ra3vld/esp32-cases/LICENSES/README.md

# License scope

Copyright (c) 2026 Dmitry E (RA3VLD).

- Python, JavaScript and HTML/CSS source code: MIT, see the root `LICENSE`.
- Enclosure CAD designs, parameters, generated STEP/STL models, drawings, documentation, renders and the contributed project photograph: Creative Commons Attribution 4.0 International (CC BY 4.0), see `CC-BY-4.0.txt`.
- The simplified CrowPanel reference model is constructed from primitives by this project and is included in the CAD license above. It is not the manufacturer's detailed STEP model.
- Font software and its embedded subsets retain the notices in `DejaVu.txt`. Third-party software installed as build dependencies retains its own license.

Attribution for the project's non-code content: "ESP32 Cases by Dmitry E (RA3VLD), https://github.com/ra3vld/esp32-cases, CC BY 4.0". Indicate changes when sharing modified content. The content license allows commercial use, modification and redistribution, including manufacture of the enclosure designs.

External reference documents linked by the project are not relicensed or included in the distribution. See the root `THIRD_PARTY_NOTICES.md`.
