ra3vld/esp32-cases/esp32-3248s035c/capsule-v01/README.md

# Капсула 0.1 — ESP32-3248S035C

Настольный корпус **142 × 91,8 × 91 мм без присосок**. Экран расположен горизонтально с наклоном **15° назад от вертикали**. Внутри предусмотрены дисплейная плата и интерфейс тюнера **40 × 25 × 25 мм**. Кабель Ø5 мм фиксируется разгрузочным зажимом.

Лицевая рамка, задняя крышка и подошва соединяются с корпусом замкнутыми бортиками **1,6 × 3 мм** с зазором **0,3 мм**. Лицевая панель без наружных винтов и дополнительного стекла. Кнопки RESET/BOOT доступны через два отверстия Ø2 мм в задней крышке.

## Файлы

- [STL для печати](output/print_stl/) — шесть деталей корпуса и два пробника, миллиметры, масштаб 100%.
- [Чертежи, 10 листов](output/capsule-v01-drawings.pdf).
- STEP сборки: `output/assembly.step` и [отдельных деталей](output/step/).
- Автономный 3D-просмотрщик: `output/capsule-3d.html`, [внешний вид](output/cad-preview.png), [разнесённая сборка](output/cad-construction.png).
- [Передний стык](output/cad-front-joint.png), [бортики и стойки](output/cad-skirts-and-roots.png), [нижний стык и спинка](output/cad-surface-details.png).

`output/stl/` содержит сетки в координатах сборки. В `output/reference_step/` находятся габаритные модели электроники, присосок и крепежа для компоновки.

Готовый комплект STEP/STL, сборка и HTML-просмотрщик находятся в [архиве корпуса из релиза](https://github.com/ra3vld/esp32-cases/releases/latest/download/ldg-capsule-v01.zip).

## Совместимость

Плата: **101,5 × 54,9 мм**, шаг креплений **94,5 × 47,9 мм**, активная область экрана **73,44 × 48,96 мм**. Размеры основаны на [документации Jingcai](https://www.guition.com/icms/upload/fb081940d6fc11f09850077a33e1404f/FTPData/UEditor/file/2026121/1768961091987/ESP32-3248S035%20Specifications-EN.pdf). Параметры посадок находятся в `parameters.json`.

Карман стекла: **85,5 × 54,9 мм** с зазором **0,3 мм** по сторонам; стекло углублено на **1,7 мм** от лицевой поверхности. Опоры PCB имеют высоту **3,8 мм**. Центр окна смещён вправо на **2 мм** относительно центра платы при взгляде спереди. Для USB предусмотрен корпус штекера до **23 × 12 × 6,8 мм**.

Перед полной печатью примерить плату, стекло, USB-штекер и световые отверстия на пробнике `08_board_coupon`; оси кнопок сверить с задней крышкой. Для другой ревизии платы скорректировать посадки в параметрах. Термовставки и присоски подобрать на пробнике `07_fit_coupon`.

## Печать

| Файл | Ориентация в `print_stl` | Поддержки |
|---|---|---|
| `01_front_frame` | Лицевой плоскостью на стол, опорами вверх | Не нужны. Непрозрачный тёмный PETG; оптические отверстия оставить чистыми. |
| `02_body` | Нижним торцом на стол | Под нижним носом, верхом переднего проёма и нависающими внутренними опорами. Удаление доступно через три открытых проёма. |
| `03_rear_cover` | Задней центральной площадкой вниз, бортиком вверх | Локальные поддержки от стола под краями оболочки и внутренними площадками, плюс brim. Отверстия кнопок Ø2 не заполнять поддержками; выступающих трубок нет. |
| `04_sole` | Наружной нижней плоскостью вниз | Не нужны; проверить короткие мосты над цековками. |
| `05_interface_cassette` | Широкой нижней плоскостью вниз | Не нужны; каналы стяжек открыты снизу. |
| `06_cable_clamp` | Верхней плоскостью вниз, канавкой вверх | Не нужны. Нижняя половина зажима встроена в подошву. |
| `07_fit_coupon` | Плоской стороной вниз | Печатать первым, затем разделить элементы по перемычкам 0,6 мм. |
| `08_board_coupon` | Лицевой плоскостью вниз | Печатать первым для примерки платы, стекла, USB и оптики. |

Начальный профиль: слой **0,20 мм**, **4 периметра**, **5 верхних/нижних слоёв**, заполнение **25%**. Вокруг стоек и их корней - локально **6 периметров и 50%**. Температуры и обдув - по своему PETG. Компенсацию слоновьей ноги настроить по пробнику. Положение поддержек проверить в слайсере.

## Бортики и крепёж

Бортики **1,6 × 3 мм**, заходная фаска **0,2 × 45°**. Они замкнуты, без разрывов у винтов, кнопок, кабеля и присосок. Снаружи бортика до направляющей стенки — **0,3 мм**; от сборочного датума до упора — **3,3 мм**, за торцом бортика остаётся **не менее 0,3 мм**. У бокового USB-окна осевой упор открыт, боковая направляющая сохранена. Между наружными торцами — **0,3 мм**. Винты стягивают отдельные опорные площадки. Приёмная ступень и свободная внутренняя полость показаны на листе 8 PDF.

Зажим кабеля: основание 30 × 10 мм на подошве, отдельная крышка толщиной 6,5 мм, два M3 × 8 и два направляющих штифта Ø2,4 × 2. Ось кабеля X = -32, Z = 13; центр зажима Y = 60,5. Входные фаски канавки Ø5 расширены до Ø5,8. До затяжки зазор половинок 0,3 мм; затягивать до удержания оболочки. Основание не обрезается полостью присоски.

Присоски: передняя пара X = ±44, Y = 20; задняя X = ±54, Y = 62. Модуль 40 × 25 × 25 расположен в центре X = 6, Y = 46, низ Z = 8. Эти положения дают запас между головками присосок, непрерывным бортиком, зажимом и стойками.

| Комплектующая | Количество | Назначение |
|---|---:|---|
| M3 × 6 ISO 7380-1 | **10** | Плата 4, подошва 4, кассета 2 |
| M3 × 8 ISO 7380-1 | **2** | Прижим кабеля |
| M3 × 10 ISO 7380-1 | **4** | Рамка изнутри |
| M3 × 12 ISO 7380-1 | **4** | Задняя крышка, головки в глубоких колодцах |
| Термовставка M3, наружный Ø4,6 × 4,0 | **20** | Рамка 8; корпус 8; подошва 4 |
| Присоска Ø20, под вставное крепление Ø6 | **4** | Эффективная толщина посадки 2 мм, сверху полость Ø12,8 |
| Стяжка 2,5 × 150 или длиннее | **2** | Интерфейс на кассете |
| Кабель наружным Ø5 | **1** | Соединение с тюнером |

Головки винтов - низкие, Ø5,7 × 1,65 мм. Другие головки или увеличенную длину сначала проверить по STEP. Начальный пилот термовставок Ø4,2 × 4,4 мм; подобрать по пробнику для фактической вставки. Не масштабировать весь корпус ради отверстий.

## Сборка и обслуживание

1. Напечатать **07 и 08**. В 07 верхний ряд слева: 5,8 / 6,0 / 6,2 мм; справа: пилоты 4,0 / 4,2 / 4,4 мм. Отделить нижние элементы, правый перевернуть и проверить стык. Проверить реальную присоску через перемычку 2 мм.
2. На 08 проверить четыре крепления, стекло, отсутствие изгиба PCB, ввод своего USB-штекера и оси оптики. Положение RESET/BOOT проверить отдельной примеркой крышки. При расхождении исправить параметры и пересобрать комплект до полной печати.
3. Напечатать детали, удалить поддержки и заусенцы. **При снятой электронике** вплавить вставки: в рамку восемь со стороны PCB; в корпус четыре сзади и четыре снизу; в подошву четыре сверху. Дать пластику остыть.
4. Прикрутить плату к опорам рамки четырьмя M3 × 6. Усилие передаётся через PCB; стекло и шлейф свободны. По принятому осевому размеру между стеклом и карманом остаётся 0,3 мм; стекло углублено относительно лицевой поверхности на 1,7 мм. LED и датчик остаются на плате; каналы раздельные.
5. При снятой подошве вставить рамку с платой спереди; через снятую заднюю крышку установить четыре M3 × 10 со стороны внутренней полости. Оси крепления рамки: U = ±54; V = ±21. Головки находятся за опорными площадками корпуса; винты входят в глухие вставки рамки. Доступ длинным шестигранником 2 мм с шаровым концом через внутренние каналы Ø5,1; отклонение к центру не более 10°. Колодцы головок Ø6,2 остаются внутри. На лицевой поверхности нет отверстий крепежа. Все крышки направляются своими бортиками относительно основного корпуса.
6. Уложить интерфейс в кассету, закрепить двумя стяжками без давления на компоненты. Прикрутить кассету к подошве двумя M3 × 6. Запас кармана по длине/ширине - 0,5 мм на сторону.
7. Провести кабель сзади, уложить в канавку подошвы, установить прижим на два M3 × 8. Подтянуть до удержания оболочки без повреждения. Оставить монтажную петлю, подключить провода. Не проводить их над антенной.
8. Установить заднюю крышку с отверстиями RESET/BOOT без направляющих трубок, закрепить четырьмя M3 × 12. Установить подошву с кассетой и четырьмя M3 × 6; не защемить провода. Вставить присоски.
9. Проверить USB, обе кнопки распрямлённой скрепкой Ø1 мм длиной от 80 мм, касания по краям, датчик при выключенном/включённом LED. Для доступа освободить зажим кабеля и отсоединить внутреннюю проводку, снять подошву с кассетой, затем снять четыре винта задней крышки и вытянуть её назад. После этого доступен внутренний крепёж передней панели.

## Пересборка CAD

Python 3.12. Выполнять из каталога `esp32-3248s035c/capsule-v01/`:

```sh
python3 -m venv .venv
.venv/bin/python -m pip install -r requirements.lock.txt
.venv/bin/python build.py
.venv/bin/python validate.py
.venv/bin/python preview.py
.venv/bin/python drawings.py
.venv/bin/python package.py
```

Для пересборки использовать исходники вместе с комплектными каталогами `output/step/`, `output/stl/`, `output/print_stl/` и файлом `compatibility-baseline.json`.

Для PDF установить шрифты DejaVu Sans; для PNG используется VTK с внеэкранным рендером. На Debian/Ubuntu шрифты устанавливаются пакетом `fonts-dejavu-core`.

Размеры и посадки задаются в `parameters.json`, форма деталей — в `build.py`. После выполнения команд готовый комплект находится в `ldg-capsule-v01.zip`.
