ra3vld/esp32-cases/crowpanel/mechanical/capsule-v03/README.md

# CrowPanel 2.1 — «Капсула», версия 0.3

Настольный корпус для Elecrow CrowPanel 2.1 с круглым экраном и энкодером. Основание **94 × 88 мм**, наклон **15° назад от вертикали**, нижний просвет **22 мм**, зазор за кольцом **1,6 мм**.

PETG, сопло **0,4 мм**, слой **0,20 мм**, стол от **180 × 180 мм**.

## Конструкция и файлы

Дисплей крепится на съёмном держателе `07_display_carrier`: четыре винта M3×12 соединяют его с корпусом, три M3×8 — со штатными металлическими стойками модуля. Ветви держателя имеют толщину **8 мм**, центральная площадка — **12 мм**. Плата и вращающееся кольцо остаются свободными.

Задняя и нижняя крышки закреплены на стойках **Ø13 мм** с рёбрами. Сзади предусмотрен выход питания **9 × 7 мм**, снизу — место под утяжелитель, магниты и присоски.

- STL для печати: `output/print_stl/`, STEP деталей: `output/step/` и сборки: `output/assembly.step`.
- Автономный 3D-просмотрщик: `output/capsule-3d.html`.
- [Внешний вид](output/cad-preview.png), [разнесённая сборка](output/cad-construction.png), [держатель и усиления](output/reinforcement-preview.png).

Готовые файлы находятся в [архиве корпуса из релиза](https://github.com/ra3vld/esp32-cases/releases/latest/download/crowpanel-capsule-0.3.zip).

## Детали для печати

Использовать детали комплекта 0.3.

Использовать **`output/print_stl/`**, миллиметры, масштаб 100%. Файлы уже ориентированы и поставлены на плоскость стола.

| Файл | Печать |
|---|---|
| `01_body.stl` | Нижним торцом на стол. Проверить локальные поддержки под передним ободом и неподвижными опорными площадками; доступ для удаления открыт через задний проём. |
| `02_rear_cover.stl` | Передней стыковочной плоскостью к столу. Брим около 5 мм, поддержки по результату слайсинга под замыкающейся стенкой и посадками винтов. |
| `03_bottom_cover.stl` | Наружной стороной к столу, рёбрами вверх. Мосты над карманами магнитов Ø12,25 мм проверить в слайсере. |
| `04_cable_clamp.stl` | Плоской нижней стороной на стол. |
| `05_fit_coupon.stl` | Пробник магнитов, присосок и термовставок, печатать первым. |
| `06_mount_test.stl` | Пробник трёх штатных стоек CrowPanel, печатать первым. |
| `07_display_carrier.stl` | **Широкой плоской задней стороной на стол**, центральной площадкой вверх. Без поддержек при нормальных мостах над цековками Ø6,2 мм. Для держателя рекомендуется 6 периметров, 6 верхних/нижних слоёв, заполнение 40–50%. |

Для остальных деталей стартовый профиль: 4 периметра, 5 верхних/нижних слоёв, заполнение 20–25%. Температура и обдув по профилю своего PETG.

`output/stl/` — те же детали в координатах сборки. `output/step/` — точные отдельные CAD-тела. `output/assembly.step` — сборка с упрощённой моделью дисплея, стальной пластиной, магнитами и винтами. Кабель и форма присосок в STEP не включены. Просмотрщик `output/capsule-3d.html` автономный, с режимами «Без задней крышки», «Без держателя», «Разнесённый вид» и «Сетка».

## Крепёж

| Комплектующая | Количество | Назначение |
|---|---:|---|
| M3×8 ISO 7380-1 | 3 | Держатель → три штатные металлические стойки CrowPanel. Заход резьбы около 3,5 мм. |
| M3×12 ISO 7380-1 | **4** | Съёмный держатель → термовставки основного корпуса. Через 8 мм пластика, около 4 мм резьбы во вставке. |
| M3×16 ISO 7380-1 | 4 | Задняя крышка → корпус. |
| M3×8 ISO 7380-1 | 4 | Нижняя крышка → корпус. |
| M3×10 ISO 7380-1 | 2 | Планка фиксации провода → корпус. |
| Термовставки M3, наружный Ø около 4,6 мм, длина 5 мм | **14** | 4 держатель + 4 задняя крышка + 4 подошва + 2 кабельная планка. Отверстия Ø4,3×5,3 мм; подобрать свои вставки по пробнику. |
| Магниты Ø12×3 мм | 4 | Карманы Ø12,25 мм, глубина 3,15 мм, вклеить после примерки. |
| Присоски с вставным хвостиком Ø6 мм | 4 | Отверстия Ø6 мм в стенке толщиной 4 мм, снизу заходная фаска. |
| Стальная пластина 72×46×10 мм | 1 | Утяжелитель около 260 г. |
| Стяжки шириной до 4 мм, толщиной до 1,2 мм, длиной от 250 мм | 2 | Закрепить утяжелитель через прорези и утопленные каналы подошвы. |
| Стяжка шириной 2,5 мм | 1 | Закрепить питание на кабельной планке. |

Принята низкая полукруглая головка ISO 7380-1 Ø5,7×1,65 мм. Высокая цилиндрическая головка может выступать ниже подошвы. Длину винтов не увеличивать без проверки глубины отверстий. Штатные металлические стойки модуля не нагревать.

## Сборка и снятие держателя

1. Напечатать `05_fit_coupon` и `06_mount_test`. Подобрать отверстие под хвостик присоски, магнит и термовставку. Проверить штатные три стойки без изгиба платы.
2. Напечатать корпус, крышки, кабельную планку и держатель. Удалить локальные поддержки и очистить посадочные поверхности.
3. Установить 14 термовставок. Четыре вставки держателя ставятся в неподвижные площадки **сзади вдоль оси дисплея**, четыре вставки задней крышки — горизонтально спереди от её стыка. Четыре нижние и две кабельные вставки ставятся снизу при открытой подошве.
4. Ввести модуль **спереди** через посадочный обод. Удерживая его рукой, завести держатель сзади. Плоские передние поверхности его четырёх ушей должны прилегать к неподвижным площадкам корпуса.
5. Наживить четыре M3×12 в корпус и три M3×8 в штатные металлические стойки. Центральная площадка держателя прилегает к торцам металлических стоек. Проверить длину одного винта вручную, затем равномерно затянуть все семь без перетяжки.
6. Пока задняя крышка снята, подключить необходимые разъёмы. Провести питание вниз и назад через проём 9×7 мм, закрепить кабельной планкой и стяжкой.
7. Вклеить магниты, вставить присоски, уложить стальную пластину и закрепить двумя стяжками. Ленты не должны выступать ниже подошвы. Нижняя крышка крепится четырьмя M3×8, задняя — четырьмя M3×16.
8. Для снятия держателя снять заднюю крышку, придерживать модуль спереди, отвернуть три M3×8 из штатных стоек и четыре M3×12 из корпуса. Держатель выводится назад **вдоль оси дисплея**, то есть с небольшим движением вниз относительно стола. Сам модуль затем извлекается вперёд.

Для нижних вставок и планки кабеля всего шесть мест. На держателе и крышках термовставок нет — там проходные отверстия.

## Посадки

Штатное кольцо Ø79 мм и его боковая поверхность остаются свободными. Координаты заводских стоек в локальной плоскости модуля: (0; 5,95), (−5,15285; −2,975), (+5,15285; −2,975) мм. Для нажатия предусмотрен осевой зазор 1 мм.

Магниты: четыре Ø12×3 мм; сверху карманов остаётся 0,85 мм пластика. Присоски: четыре вставных хвостика Ø6 мм без шпильки. Подобрать посадку хвостика пробником толщиной 4 мм. На металле присоски снять, чтобы магниты прилегали ближе к поверхности.

Пробник: верхний ряд 5,7 / 5,9 / 6,0 / 6,1 / 6,3 мм; нижние карманы магнитов 12,1 / 12,25 / 12,4 мм; крайние цилиндрики под термовставки Ø4,2 и Ø4,3 мм. Всю модель ради коррекции отверстий не масштабировать.

## Пересборка CAD

Python 3.12. Выполнять из каталога `crowpanel/mechanical/capsule-v03/`:

```sh
python3 -m venv .venv
.venv/bin/python -m pip install -r requirements.txt
.venv/bin/python build.py
.venv/bin/python refine_mesh.py
.venv/bin/python preview.py
.venv/bin/python package.py
```

Посадочные размеры задаются в `parameters.json`, форма деталей — в `build.py`. После выполнения команд готовый комплект находится в `crowpanel-capsule-0.3.zip`. Допуск STL — **0,025 мм**.

Упрощённая модель дисплея: `output/crowpanel-module-simplified.step`. Диаметр 79 мм, глубина 33,42 мм с задними разъёмами, три крепления M3.
