ra3vld/esp32-cases/THIRD_PARTY_NOTICES.md

# Third-party notices

## Fonts

The PDF drawings embed subsets of DejaVu Sans and DejaVu Sans Bold. Printable fit coupons also contain glyph outlines generated with DejaVu Sans. The font copyright and permission notices are included in `LICENSES/DejaVu.txt` and accompany the model archives.

DejaVu: https://dejavu-fonts.github.io/

## Reference dimensions

The CrowPanel reference is an original simplified model made with analytic primitives from measured overall dimensions and mounting coordinates. No surfaces or bodies from the manufacturer's detailed STEP are included. The reference preserves the 79 mm front diameter, the front/back envelope and the three M3 mounting axes. Connector bodies are represented by simple clearance envelopes.

Manufacturer information: https://github.com/Elecrow-RD/CrowPanel-2.1inch-HMI-ESP32-Rotary-Display-480-480-IPS-Round-Touch-Knob-Screen

The ESP32-3248S035 dimensions refer to the Jingcai family datasheet linked in `esp32-3248s035c/capsule-v01/sources.json`. The manufacturer's PDF is not bundled. The linked board-layout photograph is a reference only and is not bundled.

## Build dependencies

Dependencies are installed separately with pip; their binaries and source packages are not distributed in this repository or the model archives. Their licenses remain unchanged. Main components include CadQuery (Apache-2.0), OpenCascade (LGPL-2.1 with OCCT exception), CasADi (LGPL-3.0-or-later), svglib (LGPL-3.0), trimesh (MIT), NumPy/SciPy/NetworkX/VTK/ReportLab (BSD-family licenses), and Pillow (MIT-CMU).

The project licenses do not relicense these dependencies, manufacturer documents or product names.
