ra3vld/esp32-cases/crowpanel/mechanical/capsule-v03/viewer.template.html

# Капсула · CrowPanel 2.1

Настольный корпус · версия 0.3

PETG · сопло 0,4 мм

Присоски (условная форма)Скрыть правую половину корпусаСеткаМасштаб

Корпус PETGЗадняя крышкаСъёмный держательСтальной утяжелительМагниты Ø12×3Присоски с хвостиком Ø6

15° назад · нижний просвет 22 ммВращайте модель перетаскиванием. Размеры и поверхности взяты из CAD, внешний вид без фактуры печати.

Штатное крепление CrowPanelТри M3 в штатные стойки и четыре M3 для съёмного держателя. Перед корпусом — свободное кольцо энкодера и зона нажатия.

Начните с пробников05_fit_coupon.stl — присоски, магниты и вставки. 06_mount_test.stl — штатные три стойки M3.

Дисплей показан упрощённой габаритной моделью с тремя креплениями M3. Посадка присосок — под хвостик Ø6 мм; для подбора предусмотрен печатный пробник. Это автономный просмотрщик без сетевых зависимостей.
