ra3vld/esp32-cases/crowpanel/mechanical/capsule-v03/output/reinforcement-preview.png

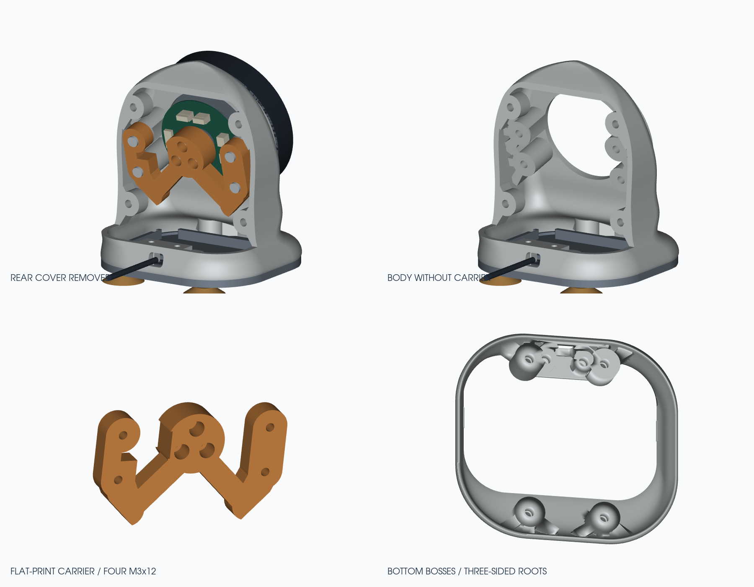
crowpanel/mechanical/capsule-v03/output/reinforcement-preview.png
