ra3vld/esp32-cases/esp32-3248s035c/capsule-v01/output/cad-skirts-and-roots.png

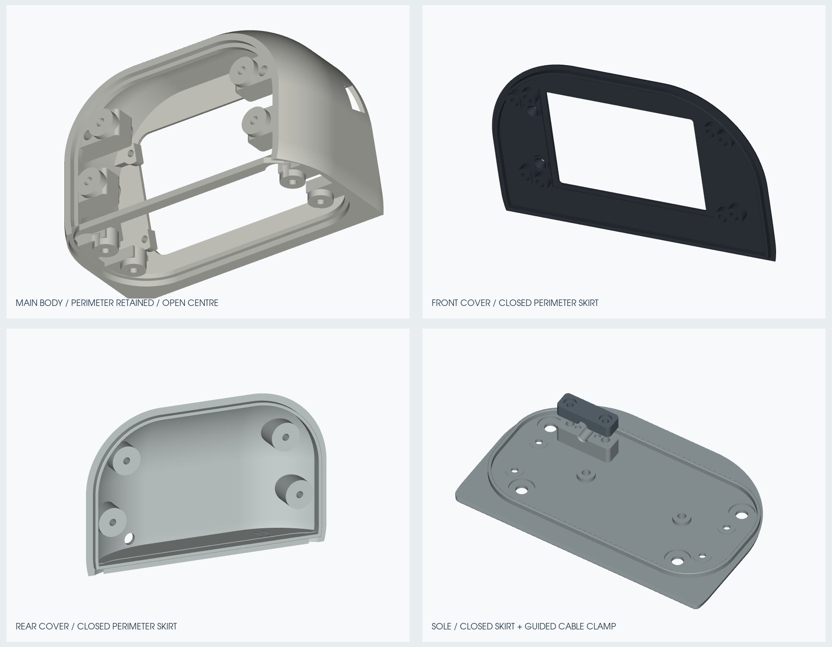
esp32-3248s035c/capsule-v01/output/cad-skirts-and-roots.png
