ra3vld/esp32-cases/esp32-3248s035c/capsule-v01/output/cad-surface-details.png

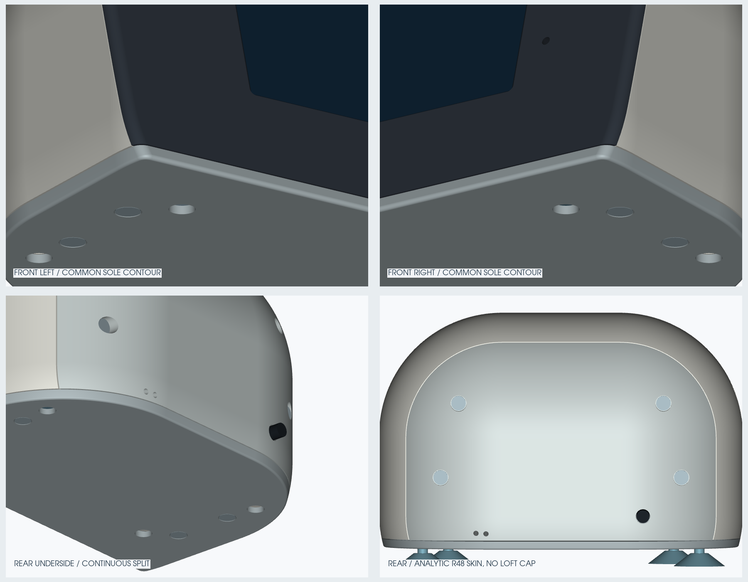
esp32-3248s035c/capsule-v01/output/cad-surface-details.png
