ra3vld/esp32-cases/esp32-3248s035c/capsule-v01/output/step/06_cable_clamp.step

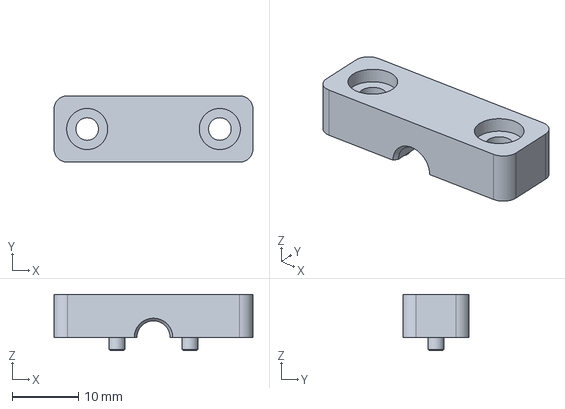
[picture p19: CAD file, 2026-11-08]
esp32-3248s035c/capsule-v01/output/step/06_cable_clamp.step
30.0 x 10.0 x 8.50 mm
