ra3vld/esp32-cases/esp32-3248s035c/capsule-v01/output/step/05_interface_cassette.step

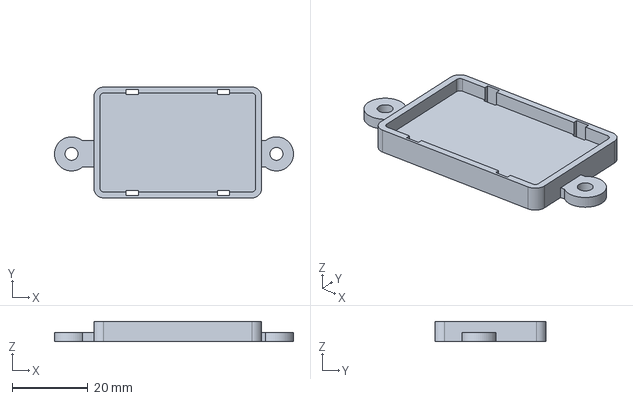
[picture p20: CAD file, 2026-11-08]
esp32-3248s035c/capsule-v01/output/step/05_interface_cassette.step
63.0 x 29.2 x 5.40 mm
