ra3vld/esp32-cases/esp32-3248s035c/capsule-v01/output/step/01_front_frame.step

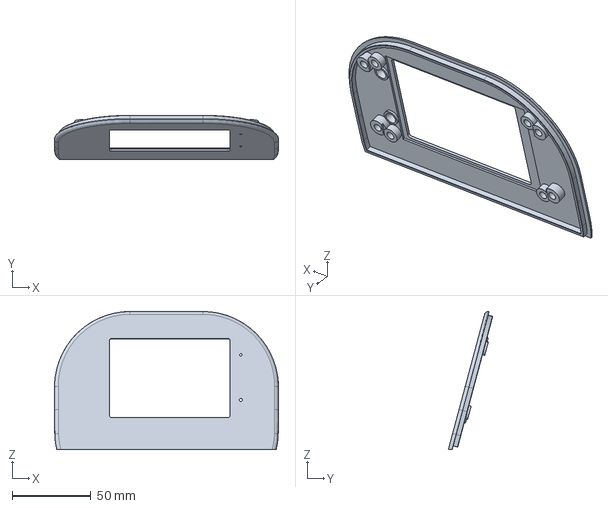
[picture p21: CAD file, 2026-11-08]
esp32-3248s035c/capsule-v01/output/step/01_front_frame.step
142.0 x 28.2 x 87.5 mm
