ra3vld/esp32-cases/esp32-3248s035c/capsule-v01/output/step/03_rear_cover.step

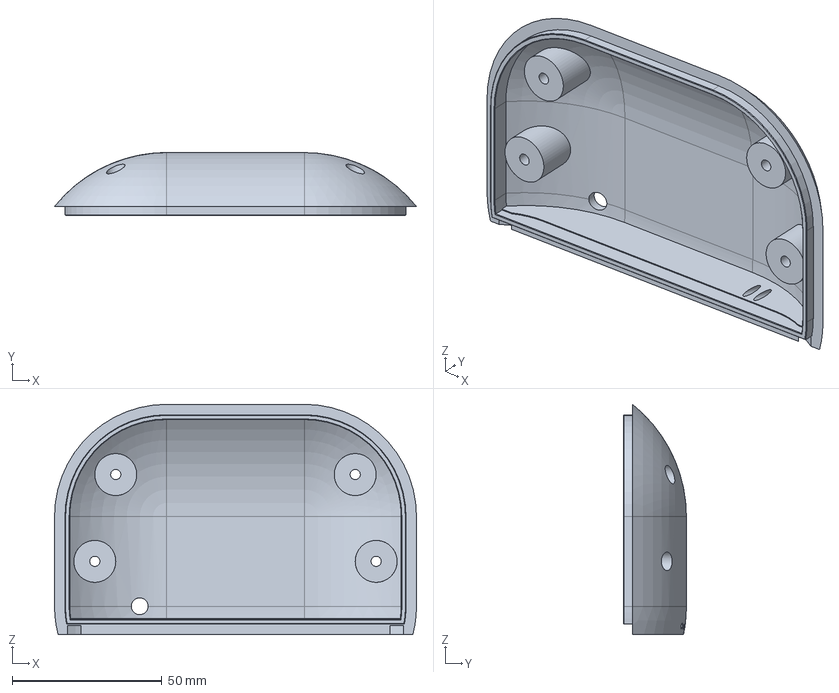
[picture p22: CAD file, 2026-11-08]
esp32-3248s035c/capsule-v01/output/step/03_rear_cover.step
120.9 x 21.0 x 77.0 mm
