ra3vld/esp32-cases/esp32-3248s035c/capsule-v01/output/step/04_sole.step

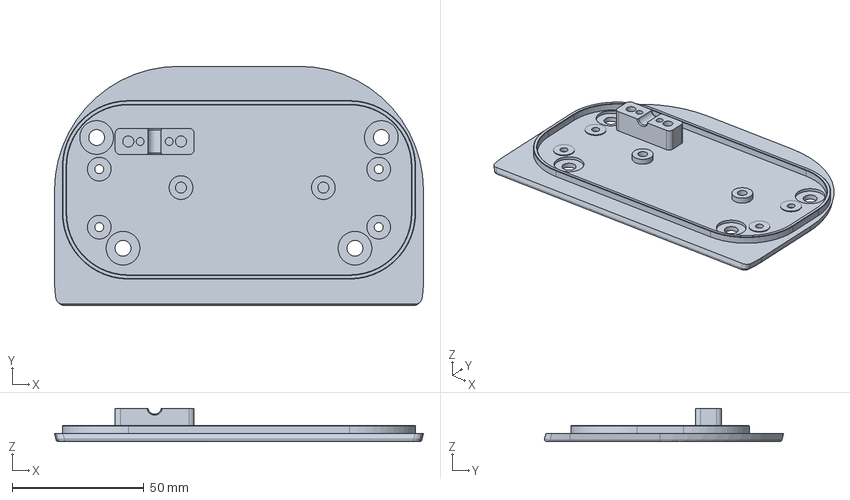
[picture p23: CAD file, 2026-11-08]
esp32-3248s035c/capsule-v01/output/step/04_sole.step
140.0 x 90.8 x 12.7 mm
