ra3vld/esp32-cases/esp32-3248s035c/capsule-v01/output/step/02_body.step

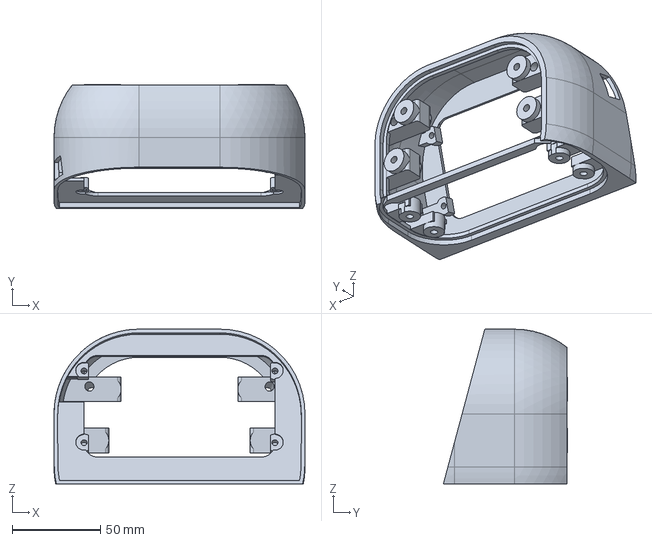
[picture p24: CAD file, 2026-11-08]
esp32-3248s035c/capsule-v01/output/step/02_body.step
142.0 x 70.3 x 87.5 mm
