ra3vld/esp32-cases/esp32-3248s035c/capsule-v01/output/step/07_fit_coupon.step

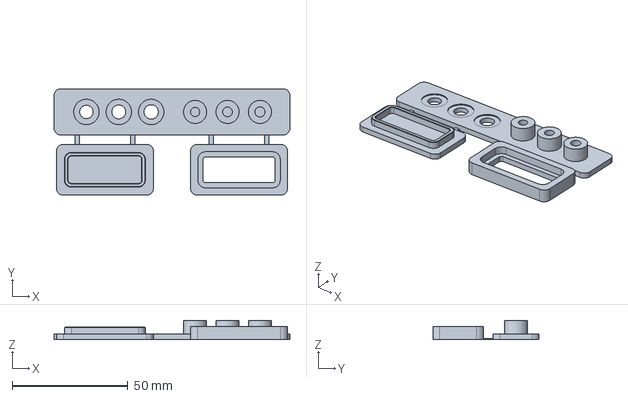
[picture p25: CAD file, 2026-11-08]
esp32-3248s035c/capsule-v01/output/step/07_fit_coupon.step
102.0 x 46.0 x 8.40 mm
