ra3vld/esp32-cases/esp32-3248s035c/capsule-v01/output/step/08_board_coupon.step

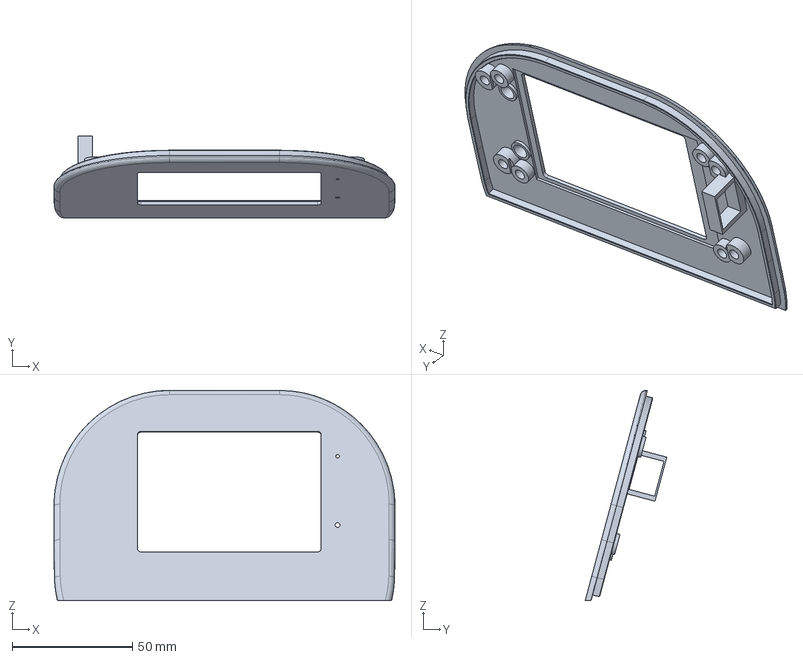
[picture p26: CAD file, 2026-11-08]
esp32-3248s035c/capsule-v01/output/step/08_board_coupon.step
142.0 x 34.0 x 87.5 mm
