ra3vld/esp32-cases/(list of files, cad)

Other CAD files:
esp32-3248s035c/capsule-v01/output/print_stl/02_body.stl
esp32-3248s035c/capsule-v01/output/print_stl/03_rear_cover.stl
esp32-3248s035c/capsule-v01/output/print_stl/04_sole.stl
esp32-3248s035c/capsule-v01/output/print_stl/05_interface_cassette.stl
esp32-3248s035c/capsule-v01/output/print_stl/06_cable_clamp.stl
esp32-3248s035c/capsule-v01/output/print_stl/07_fit_coupon.stl
esp32-3248s035c/capsule-v01/output/stl/02_body.stl
esp32-3248s035c/capsule-v01/output/stl/03_rear_cover.stl
esp32-3248s035c/capsule-v01/output/stl/04_sole.stl
esp32-3248s035c/capsule-v01/output/stl/05_interface_cassette.stl
esp32-3248s035c/capsule-v01/output/stl/06_cable_clamp.stl
esp32-3248s035c/capsule-v01/output/stl/07_fit_coupon.stl
