ra3vld/esp32-cases/crowpanel/mechanical/capsule-v03/output/cad-construction.png

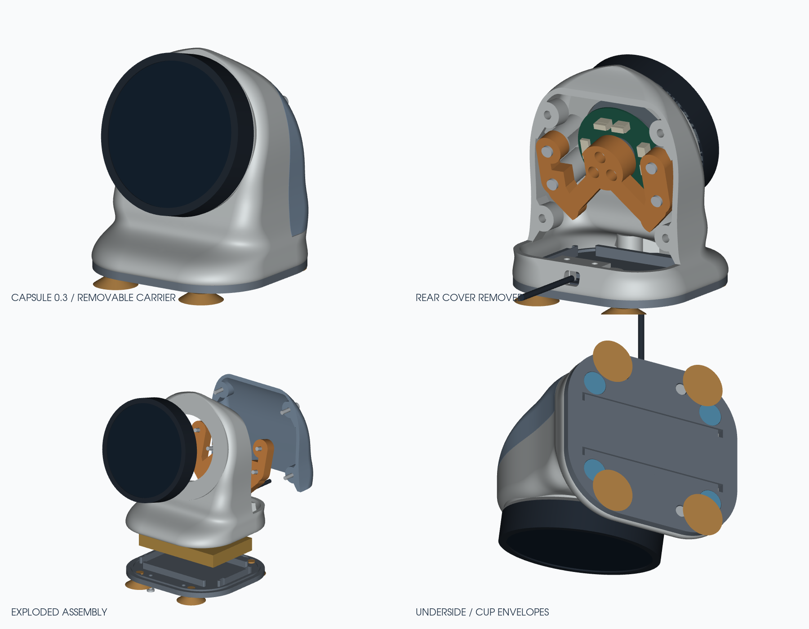
crowpanel/mechanical/capsule-v03/output/cad-construction.png
